ruthchen1020/Active_Suspension_System/README.md

# Active Suspension System for Macanum Wheels 
Mecanum wheel主動懸吊避震系統

專案目標：“畢業專題規劃表.doc”

目前進度：“Mecanum wheel主動懸吊系統.docx”
