ruthchen1020/Active_Suspension_System/v6/校正法蘭.stl

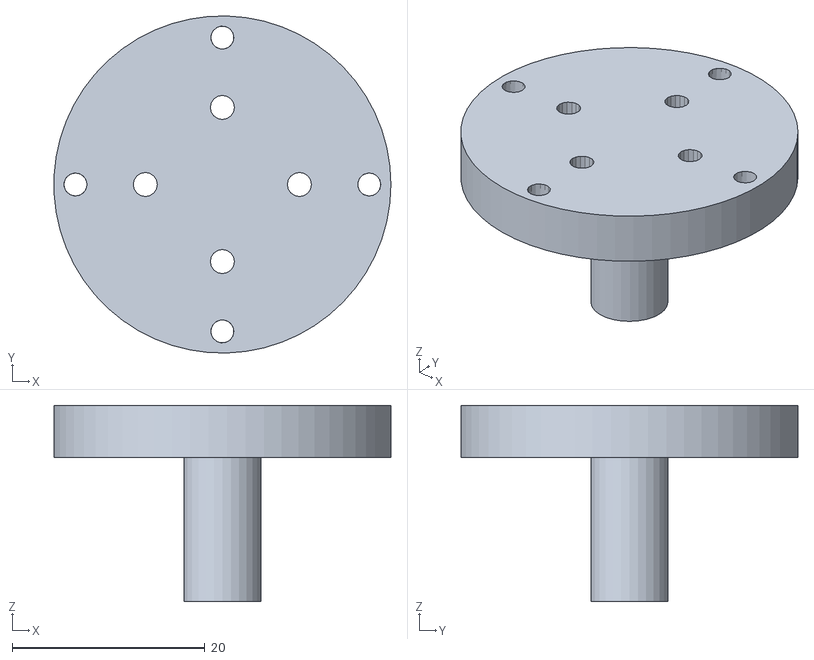
[picture p24: CAD file, 2023-11-27]
v6/校正法蘭.stl
35.0 x 35.0 x 20.4
