ruthchen1020/Active_Suspension_System/v6/A臂_螺絲3銷5.2.stl

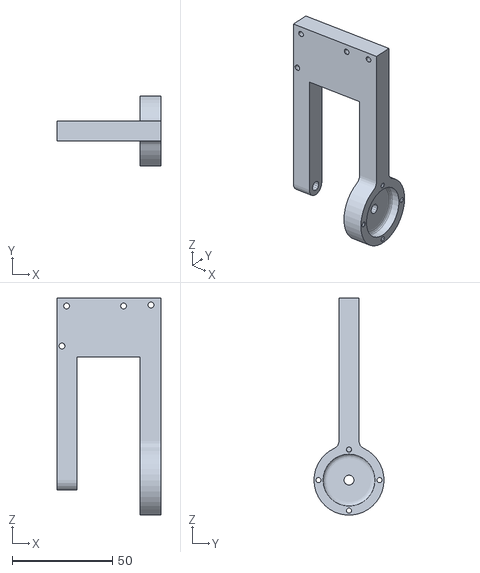
[picture p25: CAD file, 2023-11-27]
v6/A臂_螺絲3銷5.2.stl
52.0 x 35.0 x 108.4
