ruthchen1020/Active_Suspension_System/v6/L型底板.stl

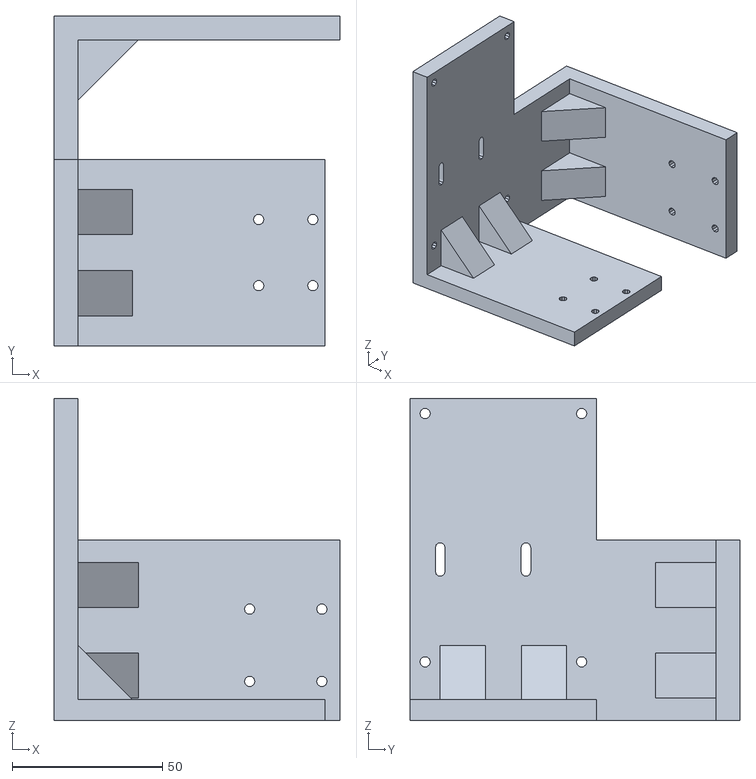
[picture p26: CAD file, 2023-11-27]
v6/L型底板.stl
95.0 x 109.6 x 107.0
