ruthchen1020/Active_Suspension_System/v6/輪軸.stl

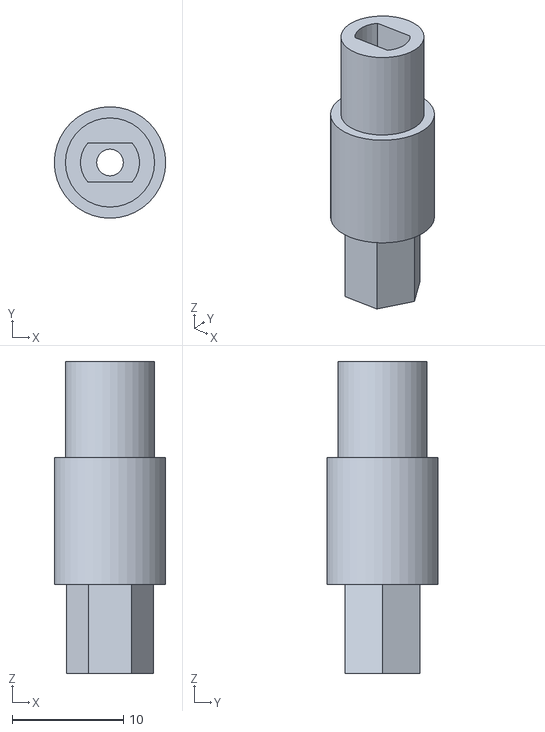
[picture p27: CAD file, 2023-11-27]
v6/輪軸.stl
10.0 x 10.0 x 28.0
