ruthchen1020/Active_Suspension_System/v6/A臂組裝零件.stl

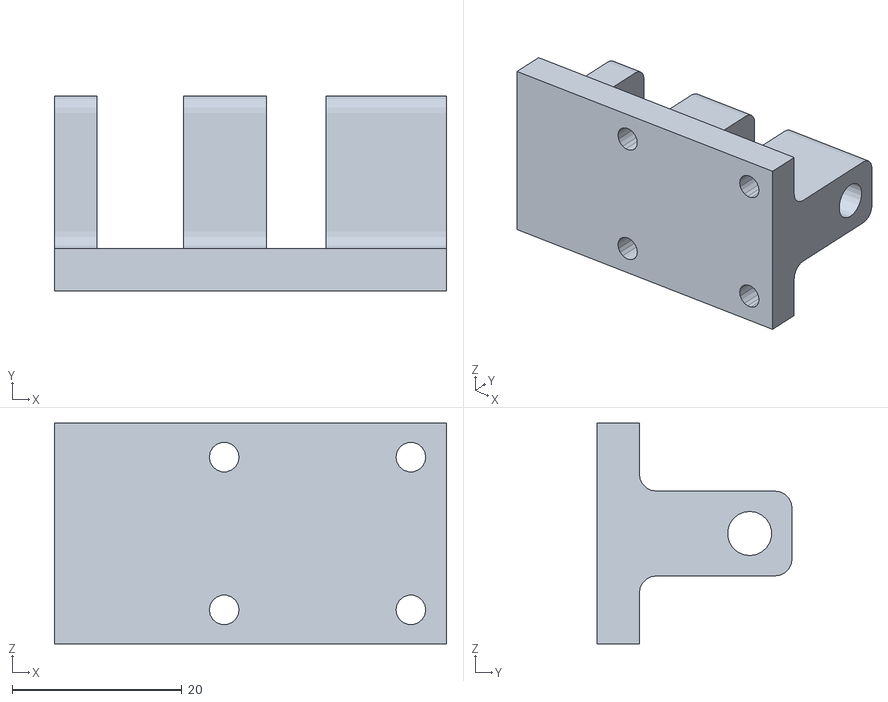
[picture p28: CAD file, 2023-11-27]
v6/A臂組裝零件.stl
46.2 x 23.0 x 26.0
