ruthchen1020/Active_Suspension_System/v6/組彈簧零件.stl

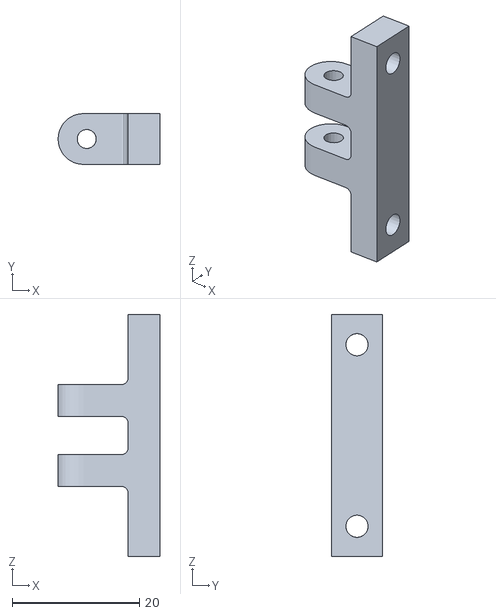
[picture p29: CAD file, 2023-11-27]
v6/組彈簧零件.stl
16.0 x 8.00 x 38.0
