ruthchen1020/Active_Suspension_System/v5/v5/馬達軸承孔座_3.2.stl

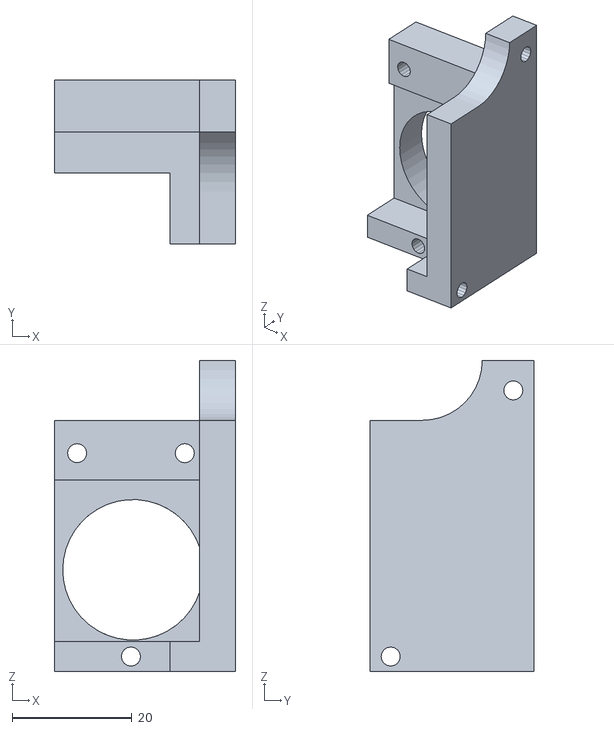
[picture p30: CAD file, 2023-11-27, an earlier design]
v5/v5/馬達軸承孔座_3.2.stl
30.3 x 27.5 x 52.0
