ruthchen1020/Active_Suspension_System/(list of files, cad)

Other CAD files:
v5/v5/A臂_螺絲3銷5.2.stl
v5/v5/校正法蘭.stl
v5/v5/L型底板.stl
